polygnomial/SleepyWoof/README.md

# SleepyWoof

PCB for radiation testing the Oresat watchdog timer circuit, using the non-SEP version of the TLV1704 quad comparator
