polygnomial/SleepyWoof/bom/bom.xlsx

null | Sourced | Placed | References | Value | Footprint | MFR | MPN | DPN | DST | Quantity
1 |  |  | C4, C5, C6, C7, C8 | 10u | C_0603_1608Metric | Murata | GRT188R61C106KE13D | 490-12317-1-ND | Digi-Key | 5
2 |  |  | C1, C2, C3 | 220u | CP_EIA-7361-38_AVX-V | Kyocera AVX | TCN4227M025R0100 | 478-12518-2-ND | Digi-Key | 3
3 |  |  | R11, R13, R14, R15, R17, R18 | 100k | R_0603_1608Metric | Stackpole Electronics Inc | RMCF0603FT100K | RMCF0603FT100KCT-ND | Digi-Key | 6
4 |  |  | R2, R3, R4, R8, R9 | 10k | R_0603_1608Metric | Stackpole Electronics Inc | RMCF0603FT10K0 | RMCF0603FT10K0CT-ND | Digi-Key | 5
5 |  |  | R5, R6, R7 | 3.0k | R_0603_1608Metric | Stackpole Electronics Inc | RMCF0603FT3K00 | RMCF0603FT3K00CT-ND | Digi-Key | 3
6 |  |  | R10, R12 | 1k | R_0603_1608Metric | Stackpole Electronics Inc | RMCF0603FT1K00 | RMCF0603FT1K00CT-ND | Digi-Key | 2
7 |  |  | R1 | 10 (1206) | R_1206_3216Metric | Rohm Semiconductor | ESR18EZPF10R0 | RHM10.0AFCT-ND | Digi-Key | 1
8 |  |  | R16 | 4.7M | R_0603_1608Metric | Stackpole Electronics Inc | RMCF0603FT4M70 | RMCF0603FT4M70CT-ND | Digi-Key | 1
9 |  |  | D1, D3 | 1N4151WS | D_SOD-323 | Vishay | 1N4151WS-E3-08 | 112-1N4151WS-E3-08CT-ND | Digi-Key | 2
10 |  |  | D2 | GREEN | LED_0603_1608Metric | Wurth | 150060GS75000 | 732-4971-1-ND | Digi-Key | 1
11 |  |  | U1 | TLV1704 | TSSOP-14_4.4x5mm_P0.65mm | Texas Instruments | TLV1704AQPWRQ1 | 296-43799-2-ND | Digi-Key | 1
12 |  |  | J1 | Conn_01x04 | PinHeader_1x04_P2.54mm_Vertical |  |  |  |  | 1
