polygnomial/SleepyWoof/fab/SleepyWoof-PTH-drl_map.dxf

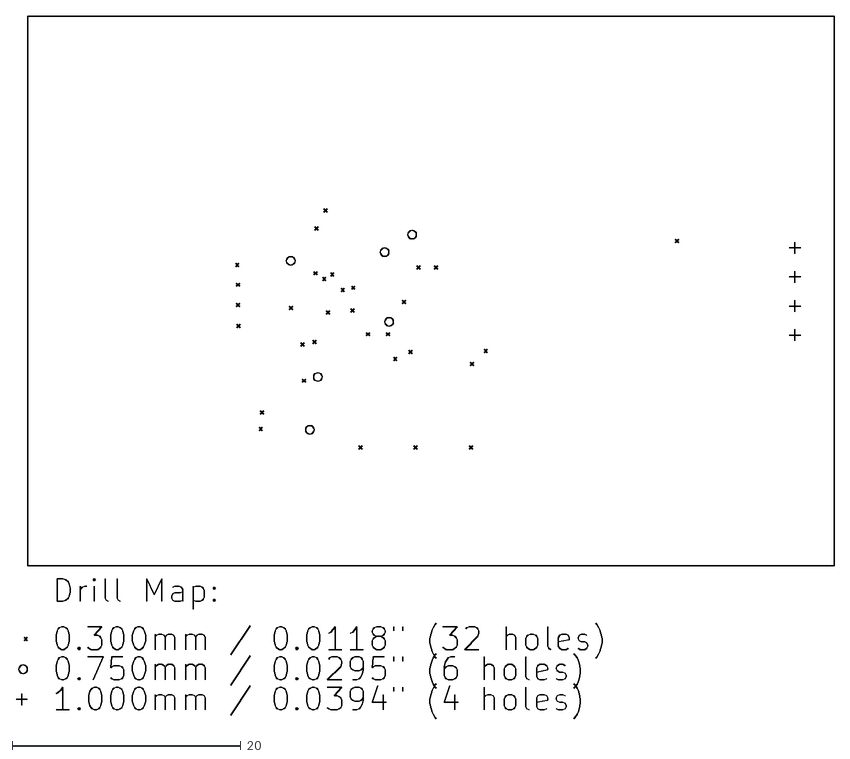
[picture p1: CAD file, 2024-08-15]
fab/SleepyWoof-PTH-drl_map.dxf
71.5 x 61.4
