polygnomial/SleepyWoof/Production/fab/SleepyWoof_panelized-NPTH-drl_map.dxf

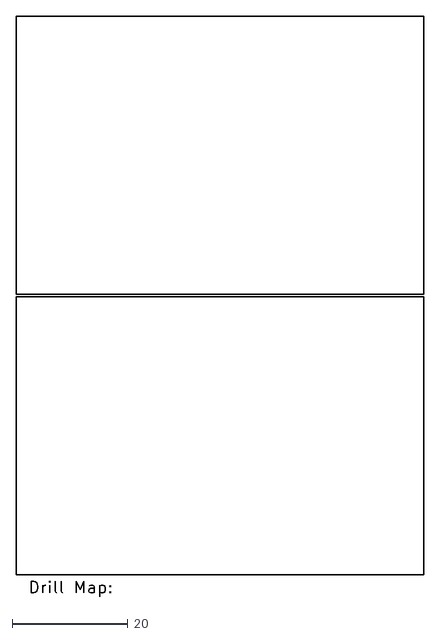
[picture p2: CAD file, 2024-08-15]
Production/fab/SleepyWoof_panelized-NPTH-drl_map.dxf
70.5 x 100.3
