polygnomial/SleepyWoof/fab/SleepyWoof-NPTH-drl_map.dxf

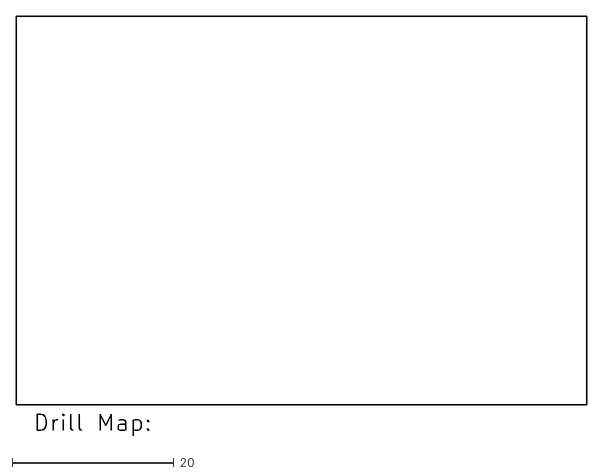
[picture p3: CAD file, 2024-08-15]
fab/SleepyWoof-NPTH-drl_map.dxf
70.5 x 51.8
