polygnomial/SleepyWoof/Production/fab/SleepyWoof_panelized-PTH-drl_map.dxf

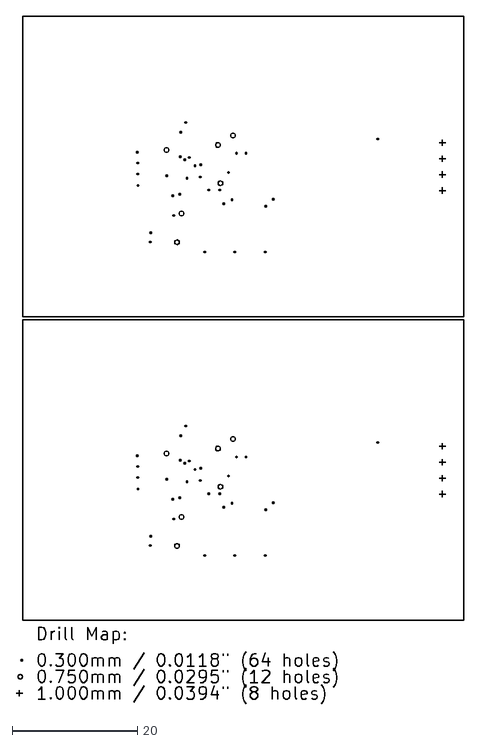
[picture p4: CAD file, 2024-08-15]
Production/fab/SleepyWoof_panelized-PTH-drl_map.dxf
71.5 x 109.9
