polygnomial/SleepyWoof/SleepyWoof.kicad_pcb

## KiCad design SleepyWoof.kicad_pcb (2024-08-15)

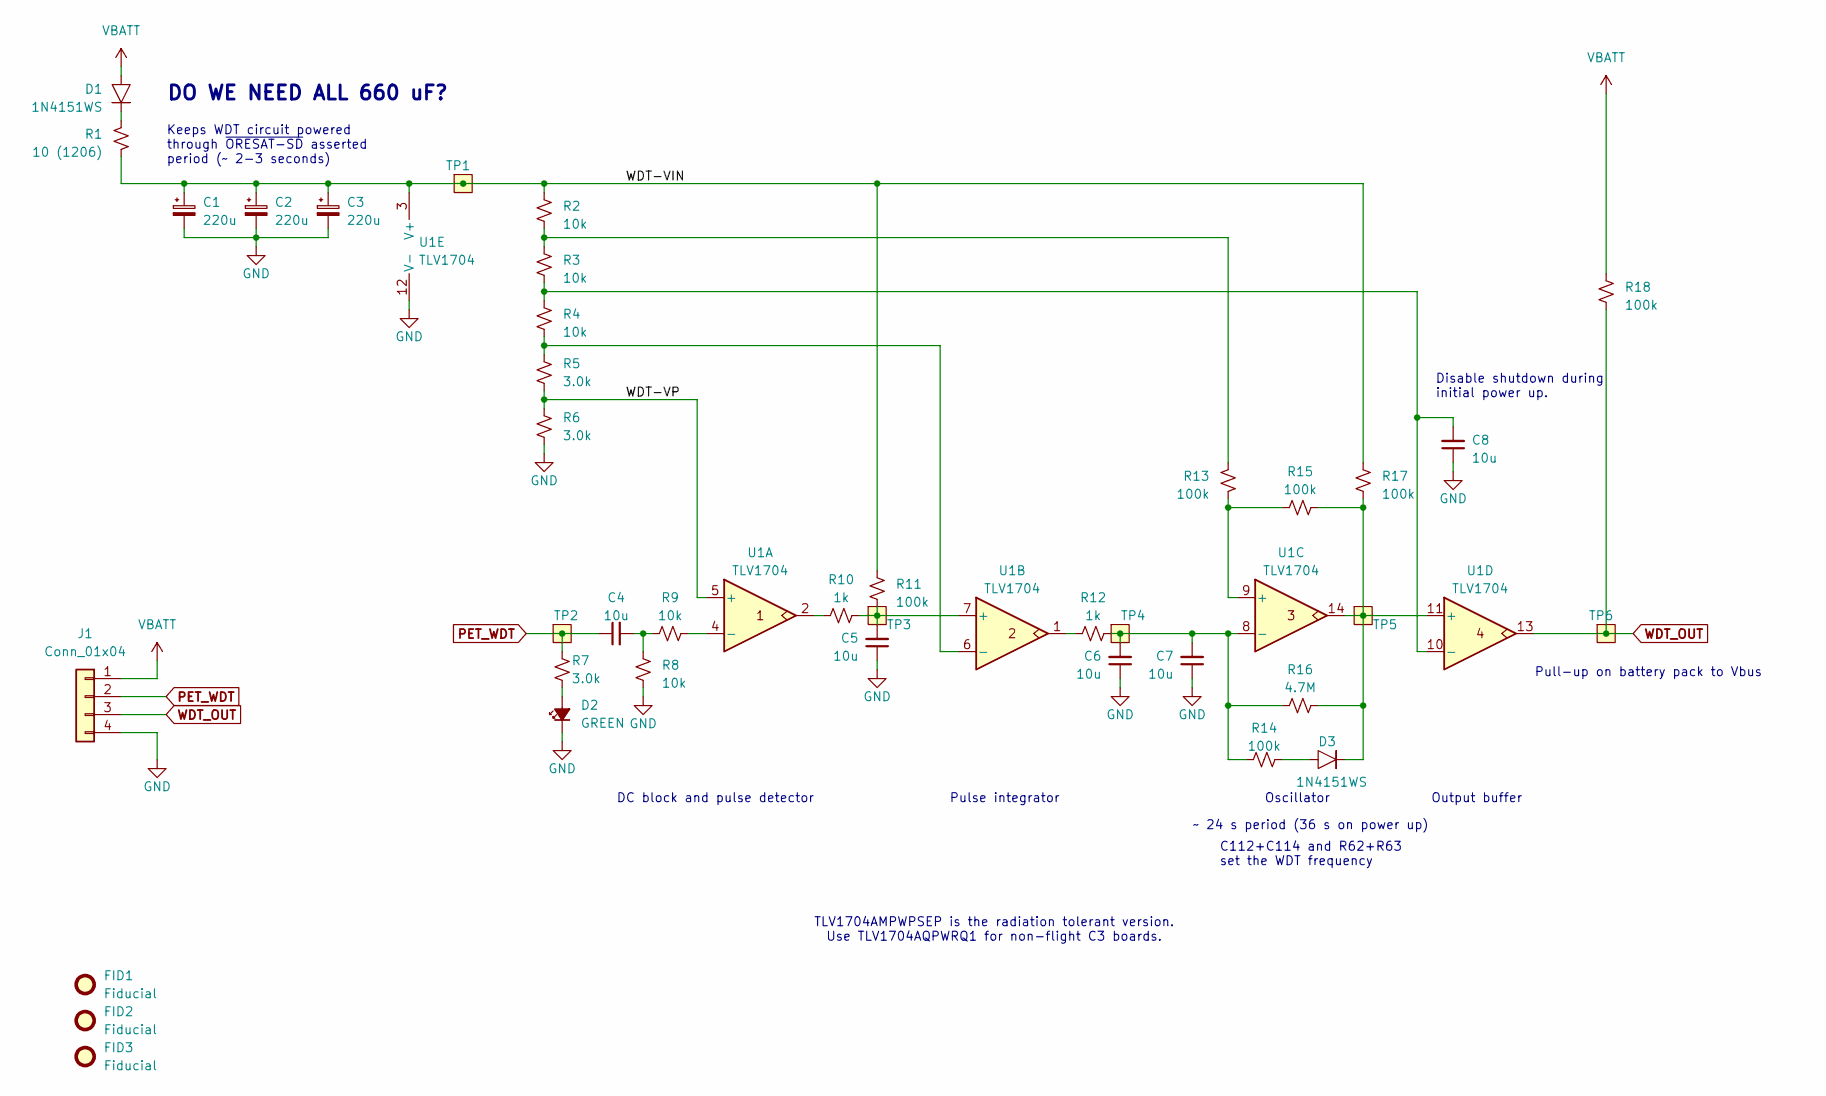
[picture p5: schematic SleepyWoof.kicad_sch]

Parts:
C1, C2, C3: 220u; CP_EIA-7361-38_AVX-V; MPN TCN4227M025R0100
C4, C5, C6, C7, C8: 10u; C_0603_1608Metric; MPN GRT188R61C106KE13D
D1, D3: 1N4151WS; D_SOD-323; MPN 1N4151WS-E3-08
D2: GREEN; LED_0603_1608Metric; MPN 150060GS75000
FID1, FID2, FID3: Fiducial; Fiducial_1mm_Mask2mm
J1: Conn_01x04; PinHeader_1x04_P2.54mm_Vertical
R1: 10 (1206); R_1206_3216Metric; MPN ESR18EZPF10R0
R2, R3, R4, R8, R9: 10k; R_0603_1608Metric; MPN RMCF0603FT10K0
R5, R6, R7: 3.0k; R_0603_1608Metric; MPN RMCF0603FT3K00
R10, R12: 1k; R_0603_1608Metric; MPN RMCF0603FT1K00
R11, R13, R14, R15, R17, R18: 100k; R_0603_1608Metric; MPN RMCF0603FT100K
R16: 4.7M; R_0603_1608Metric; MPN RMCF0603FT4M70
TP1, TP2, TP3, TP4, TP5, TP6: TestPoint-MinTH; TestPoint-0.75mm-th
U1: TLV1704; TSSOP-14_4.4x5mm_P0.65mm; MPN TLV1704AQPWRQ1

Connections:
/WDT-VIN: C1.1, C2.1, C3.1, R1.2, R2.1, R11.1, R17.2, TP1.1, U1.3 (V+)
/WDT-VP: R5.2, R6.1, U1.5 (+)
GND: C1.2, C2.2, C3.2, C5.1, C6.1, C7.1, C8.1, D2.1 (K), J1.4, R6.2, R8.2, U1.12 (V-)
unnamed: C4.2, R8.1, R9.1
unnamed: D1.1, R1.1
unnamed: D2.2 (A), R7.2
unnamed: D3.2, R14.1
unnamed: R10.1, U1.2
unnamed: R12.1, U1.1
unnamed: R2.2, R3.1, R13.2
unnamed: R9.2, U1.4 (-)
unnamed: C5.2, R10.2, R11.2, TP3.1, U1.7 (+)
unnamed: R4.2, R5.1, U1.6 (-)
unnamed: R13.1, R15.1, U1.9 (+)
unnamed: C6.2, C7.2, R12.2, R14.2, R16.2, TP4.1, U1.8 (-)
unnamed: D3.1, R15.2, R16.1, R17.1, TP5.1, U1.11 (+), U1.14
unnamed: C8.2, R3.2, R4.1, U1.10 (-)
PET_WDT: C4.1, J1.2, R7.1, TP2.1
VBATT: D1.2, J1.1, R18.2
WDT_OUT: J1.3, R18.1, TP6.1, U1.13

Notes on the sheet:
Pulse integrator
Output buffer
Oscillator
C112+C114 and R62+R63 set the WDT frequency
TLV1704AMPWPSEP is the radiation tolerant version. Use TLV1704AQPWRQ1 for non-flight C3 boards.
Pull-up on battery pack to Vbus
DO WE NEED ALL 660 uF?
DC block and pulse detector
Disable shutdown during initial power up.
Keeps WDT circuit powered through ~{ORESAT-SD} asserted period (~ 2-3 seconds)
~ 24 s period (36 s on power up)

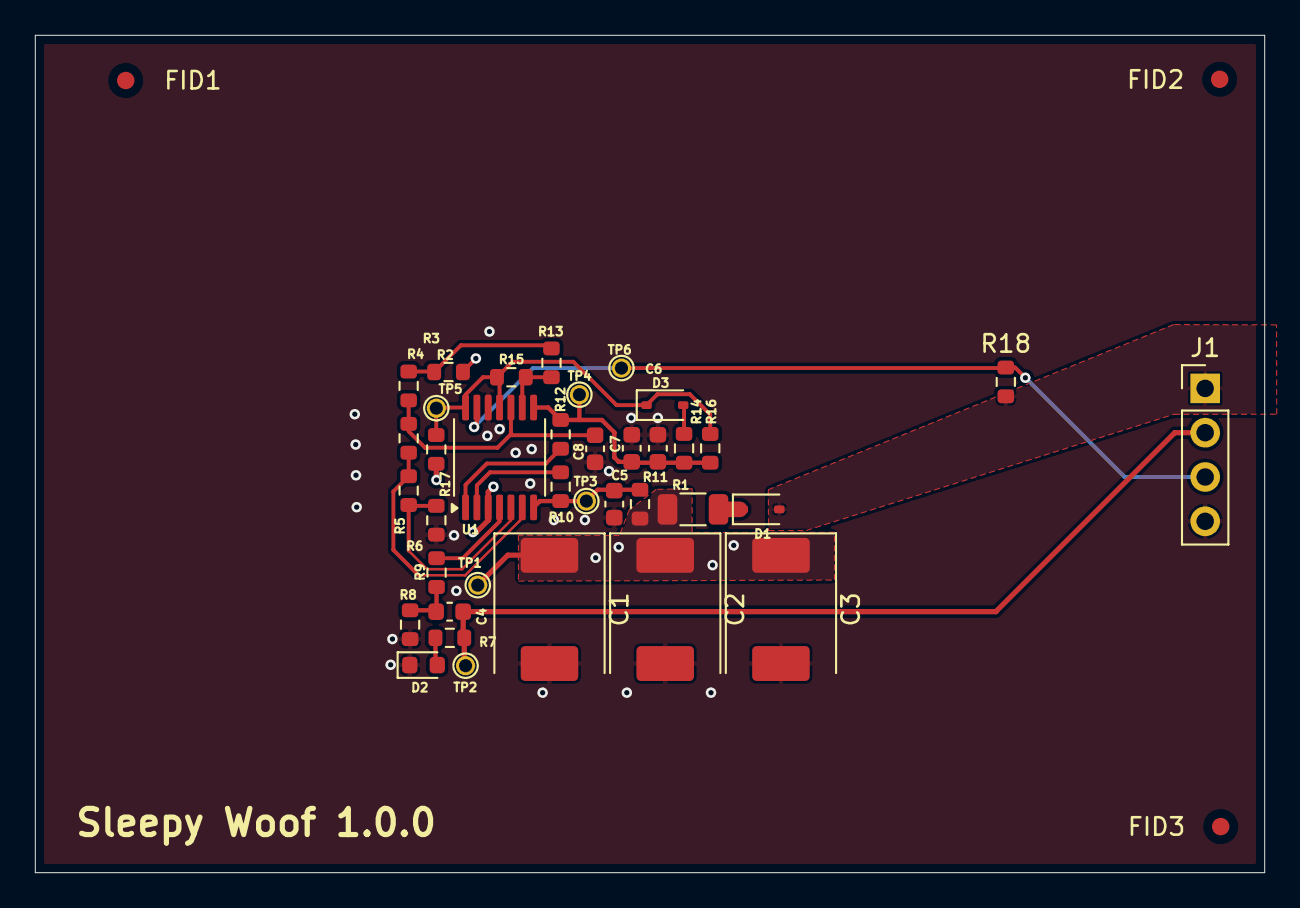
[picture p6: board SleepyWoof.kicad_pcb from above]

Board: 2 copper layers, 70.5 x 48.0 mm, 40 parts (0 on the bottom side), 20 nets.
