polygnomial/SleepyWoof/Production/ordering_instructions.txt

Ordering Instructions:
Panel dimensions: 70.47 x 96.50 mm.
Solder Mask: Red (Default)
Silkscreen: White (Default)
Layers: 2
Finish: HASL Lead-free (Default)
Thickness: 1.6mm (Default)
Copper weight: 1oz (Default)
Minimum track width: 0.15mm (5.91mil)
Minimum via drill: 0.30mm (11.81mil)
